ZitanGong/FPGAcomp_2026/README.md

# Tang Mega NEO 138K 实时多音色合成器

version:2026.10.03

MPR121 八段触摸分别控制八对 LED：P1→LED1、2，依次到 P8→LED15、16，松手熄灭。依据通道错位的实测现象，默认改取 ELE0～ELE7（顶层 TOUCH_FIRST=0，可设为 1）；须上板核对两端。自动初始化、I²C 读取、逐段映射和两片 74HC595 发送均由 FPGA 完成。原有键盘和 PT8211 音频继续运行，标准 I²S 未启用。

LED 引脚已按当前接线设为 `led_data=C20`、`led_clk=D19`、`led_lat=C19`；原来占用 D19 的 `dbg_frame` 已移至 E19，避免 PR2016 引脚冲突。模块说明、接线、仿真及上板步骤见 [触摸滑条说明](docs/touch-slider.md)。

当前启用 GAO，最新下载文件是 [impl/pnr/ao_0.fs](impl/pnr/ao_0.fs)，配套配置为 [src/touch_dbg.rao](src/touch_dbg.rao)。保留的 `synth21.fs` 和 `synth21_known_good.fs` 是此前版本，不包含本次完整更新。最新位流 SHA256：`883160AC79819AE62F9A5B124F55C56E7EFA3B51054EC89436EFB2A45DEA68DE`。

## KEY0 音色切换

底板丝印 KEY0（USER_BUTTON0，FPGA 管脚 AA13）每次按下切换一种音色，
约 10 ms 硬件消抖。KEY1（AB13）降低音量，KEY2（Y12）提高音量；
音量共 8 级（0 级静音），上电默认为 5 级。系统使用约 1.25 ms 的 FPGA
上电复位，不再占用实体按键：

0. 正弦
1. Hammond 拉杆风琴（官方 `00 8877 760` 注册）
2. 拨弦乐器（21 路 Karplus–Strong 独立物理模型）
3. 钢琴简化模态音色（低／中高音区独立频谱、双阶段衰减）

四组音色仍以 `4 x 1024` 个地址打包在 `rom/timbres4.hex` 中，但每个地址
同时保存 16 位起音波形和 16 位琴体波形。钢琴在发音后逐样本完成频谱渐变，
并按低音区和中高音区选用分别计算的模型。音色 2 不读取波表，而是使用噪声
激励、可调延迟线和反馈阻尼逐样本生成拨弦声。修改模型后运行
`python tools/gen_timbres.py` 可重新生成 ROM；参数出处和工程近似见
`docs/timbre-models.md`。

拨弦音色使用与波表音色分离的平坦响度曲线，并按延迟线长度分配环路损耗，
使高低音区具有接近的按住衰减时间；松键后保留约 1 秒量级的余音尾。

## 2026-10-02 更新

- 将拨弦音色的初始噪声激励右移由 `>>>2` 调整为 `>>>1`。该修改影响音色 2
  的全部 21 个声部，使 C3、F3、B4 等原先偏哑的音恢复正常的起拨亮度与响度；
  正弦、Hammond 风琴和钢琴音色不使用该激励，因此不受影响。
- 对扫描索引 5（D3，`KS_DELAY=348`）使用固定 LFSR 种子 `16'hACE1`，消除了
  第三个测试项后仍残留的 D3 发哑问题。其余音符继续使用
  `16'hACE1 ^ KS_DELAY`。
- 21 个拨弦音已经过主观试听确认恢复正常。当前的验证没有使用音频接口或
  频谱分析，后续仍需通过线路录音检查峰值、基频、谐波、余音衰减和 21 音
  齐奏时的削波情况。
- 已重新生成并更新 `impl/pnr/synth21.fs`。

上述改动位于 `src/synth/voice.v`。当前 D3 修正仍以 `KS_DELAY == 348`
作为测试条件；后续如需继续调整，建议改为给 `voice` 增加每音独立的
`KS_SEED` 参数，避免在算法模块中保留硬编码。

21 个音符还带有按音区变化的 Q1.15 键位响度补偿曲线。低八度全部保留
完整幅度，中八度从 55% 平滑衰减至 46%，高八度从 41% 衰减至 31%。
第 5 级默认总增益同步提高，低八度较上一版再提高约 2 dB，中高八度
实际输出基本维持原听感。该曲线位于 `src/synth/synth21.v`。

按键串行输入：OUT2 接 PMOD0 J9-8（R17），OUT3 接 PMOD0 J9-7（P16）。
