ZitanGong/FPGAcomp_2026/src/synth/mix21.v

module mix21 #(parameter SHIFT = 5, parameter GAIN=1)(
    input clk, input rst, input valid,
    input [335:0] pcm,
    input [2:0] volume,
    output reg signed [15:0] out,
    output reg done, output reg clip
);
    reg signed [16:0] s1 [0:15];
    reg signed [17:0] s2 [0:7];
    reg signed [18:0] s3 [0:3];
    reg signed [19:0] s4 [0:1];
    reg signed [20:0] s5;
    wire signed [23:0] wide={{3{s5[20]}},s5};
    wire signed [23:0] gain=(GAIN==3) ? wide+(wide<<<1) : wide;
    // Approximate perceptual steps around level 4.  Level 4 is exactly the
    // former gain; KEY1 moves down, KEY2 moves up, and level 0 is mute.
    reg [4:0] volume_gain;
    always @* begin
        case(volume)
            3'd0: volume_gain=5'd0;
            3'd1: volume_gain=5'd1;
            3'd2: volume_gain=5'd2;
            3'd3: volume_gain=5'd4;
            3'd4: volume_gain=5'd8;
            3'd5: volume_gain=5'd14;
            3'd6: volume_gain=5'd18;
            default: volume_gain=5'd24;
        endcase
    end
    localparam VSHIFT=SHIFT+3;
    wire signed [29:0] gain_ext={{6{gain[23]}},gain};
    wire signed [5:0] volume_gain_signed={1'b0,volume_gain};
    wire signed [35:0] volume_product=gain_ext*volume_gain_signed;
    wire signed [35:0] rounded=volume_product+
        (36'sd1<<<(VSHIFT-1))-(volume_product[35] ? 36'sd1 : 36'sd0);
    wire signed [35:0] scaled=rounded>>>VSHIFT;
    wire signed [15:0] x [0:31];
    reg [4:0] v;
    genvar g;
    generate for (g=0;g<32;g=g+1) begin: IN
        if (g<21) assign x[g] = pcm[g*16 +: 16];
        else assign x[g] = 16'sd0;
    end endgenerate
    integer i;
    always @(posedge clk) begin
        if (rst) begin
            v<=0; done<=0; out<=0; clip<=0; s5<=0;
            for(i=0;i<16;i=i+1) s1[i]<=0;
            for(i=0;i<8;i=i+1) s2[i]<=0;
            for(i=0;i<4;i=i+1) s3[i]<=0;
            for(i=0;i<2;i=i+1) s4[i]<=0;
        end else begin
            v<={v[3:0],valid}; done<=v[4];
            if(valid) for(i=0;i<16;i=i+1)
                s1[i] <= {x[2*i][15],x[2*i]} + {x[2*i+1][15],x[2*i+1]};
            if(v[0]) for(i=0;i<8;i=i+1)
                s2[i] <= {s1[2*i][16],s1[2*i]} + {s1[2*i+1][16],s1[2*i+1]};
            if(v[1]) for(i=0;i<4;i=i+1)
                s3[i] <= {s2[2*i][17],s2[2*i]} + {s2[2*i+1][17],s2[2*i+1]};
            if(v[2]) for(i=0;i<2;i=i+1)
                s4[i] <= {s3[2*i][18],s3[2*i]} + {s3[2*i+1][18],s3[2*i+1]};
            if(v[3]) s5 <= {s4[0][19],s4[0]} + {s4[1][19],s4[1]};
            if(v[4]) begin
                clip <= 0;
                if(scaled > 36'sd32767) begin out<=16'sh7fff; clip<=1; end
                else if(scaled < -36'sd32768) begin out<=16'sh8000; clip<=1; end
                else out <= scaled[15:0];
            end
        end
    end
endmodule
