ZitanGong/FPGAcomp_2026/(commit log)

2026-09-26 Fix switch notes without remapping key logic
    [audio_core.v, tb_board.sv, tb_core.sv, tb_map.sv, tb_pt_core.sv, tb_quality.sv, tb_synth.sv]
2026-10-03 Add MPR121 touch LED pairs, GAO debugging and verified bitstream
